SilvaTayane/Transmissao-de-Audio-com-Esp32/README.md

# Transmissao-de-Audio-com-Esp32
Transmissao de Audio sem fio com Esp32 e Módulos
